Hypha-Home/HyphaHome-Sens/case/Hypha Home - Sense.3mf

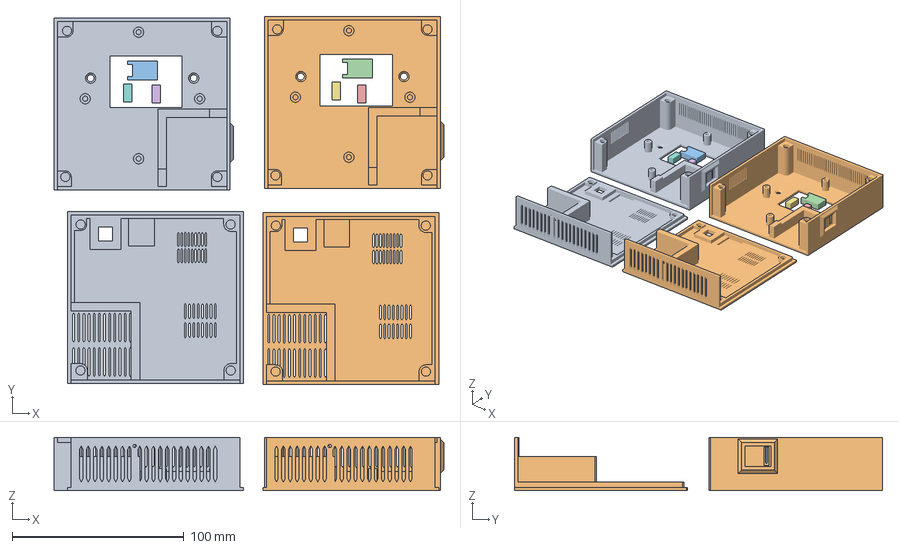
[picture p7: CAD file, 2026-10-26]
case/Hypha Home - Sense.3mf
226.9 x 214.2 x 31.0 mm
Backplate x 2
Abstandshalter LD2410 x 2
Abstandshalter x 4
Front x 2
