Hypha-Home/HyphaHome-Sens/case/Front.3mf

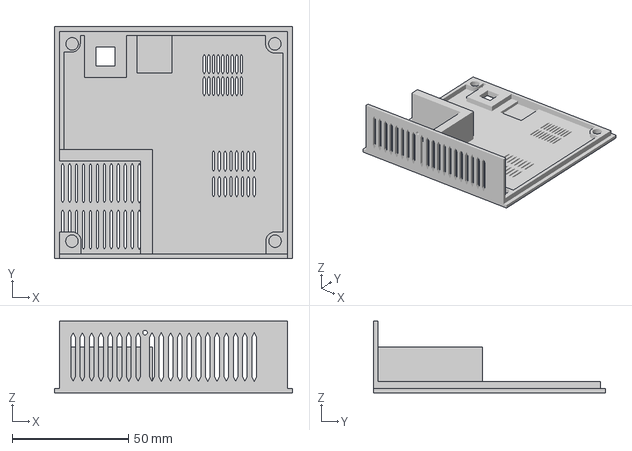
[picture p8: CAD file, 2026-10-26]
case/Front.3mf
102.5 x 100.0 x 31.0 mm
