Hypha-Home/HyphaHome-Sens/(list of files, cad)

Other CAD files:
case/Multisensor V2.f3d
