Hypha-Home/HyphaHome-Sens/hardware/Hypha Home - Sens - Rev.2/Hypha Home - Sens - Rev.2.kicad_pcb

## KiCad design hardware/Hypha Home - Sens - Rev.2/Hypha Home - Sens - Rev.2.kicad_pcb (2026-10-26)

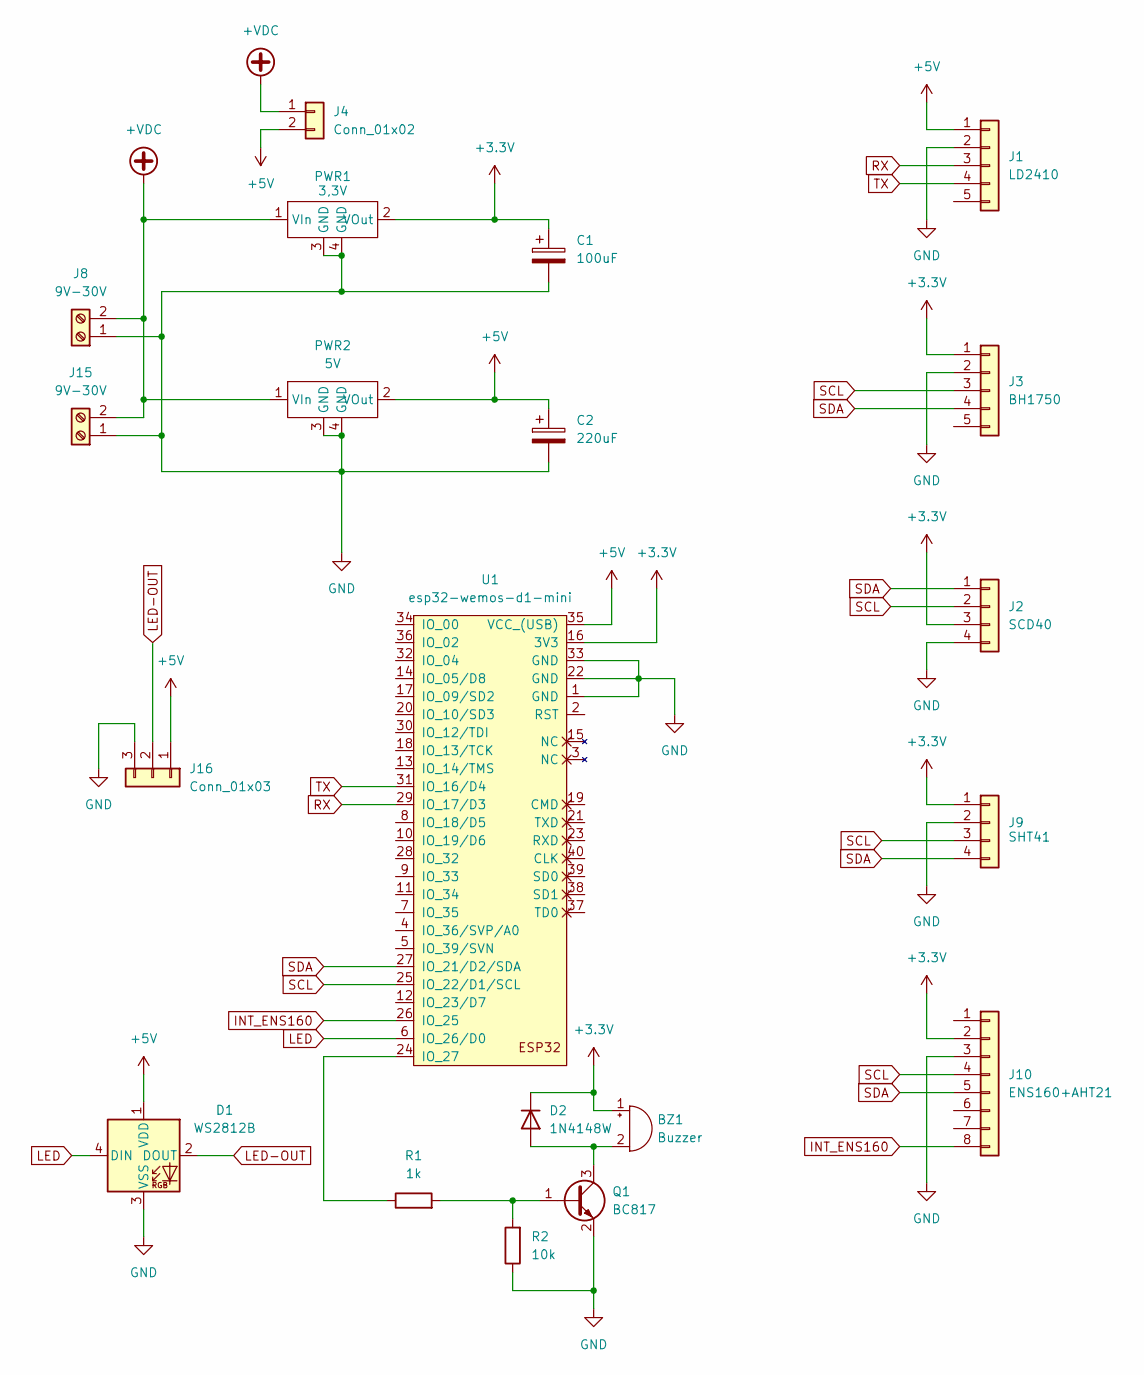
[picture p9: schematic Hypha Home - Sens - Rev.2.kicad_sch]

Parts:
BZ1: Buzzer; Buzzer_D9_RM5
C1: 100uF; CP_Radial_D5.0mm_P2.00mm
C2: 220uF; CP_Radial_D6.3mm_P2.50mm
D1: WS2812B; LED_WS2812B_PLCC4_5.0x5.0mm_P3.2mm
D2: 1N4148W; D_SOD-323_HandSoldering
J1: LD2410; PinHeader_1x05_P1.27mm_Vertical
J2: SCD40; PinHeader_1x04_P2.54mm_Vertical
J3: BH1750; PinHeader_1x05_P2.54mm_Vertical
J4: Conn_01x02; PinHeader_1x02_P2.54mm_Vertical
J8, J15: 9V-30V; TerminalBlock_MaiXu_MX126-5.0-02P_1x02_P5.00mm
J9: SHT41; PinHeader_1x04_P2.54mm_Vertical
J10: ENS160+AHT21; PinHeader_1x08_P2.54mm_Vertical
J16: Conn_01x03; PinHeader_1x03_P2.54mm_Vertical
PWR1: 3,3V; Spannungswandler
PWR2: 5V; Spannungswandler
Q1: BC817; SOT-23
R1: 1k; R_0805_2012Metric
R2: 10k; R_0805_2012Metric
U1: esp32-wemos-d1-mini

Connections:
+3.3V: BZ1.1 (+), C1.1, D2.1 (K), J2.3, J3.1, J9.1, J10.2, PWR1.2 (VOut), U1.16 (3V3)
+5V: C2.1, D1.1 (VDD), J1.1, J4.2, J16.1, PWR2.2 (VOut), U1.35 (VCC_(USB))
+VDC: J4.1, J8.2, J15.2, PWR1.1 (VIn), PWR2.1 (VIn)
GND: C1.2, C2.2, D1.3 (VSS), J1.2, J2.4, J3.2, J8.1, J9.2, J10.3, J15.1, J16.3, PWR1.3 (GND), PWR1.4 (GND), PWR2.3 (GND), PWR2.4 (GND), Q1.2 (E), R2.1, U1.1 (GND), U1.22 (GND), U1.33 (GND)
INT_ENS160: J10.8, U1.26 (IO_25)
LED: D1.4 (DIN), U1.6 (IO_26/D0)
LED-OUT: D1.2 (DOUT), J16.2
unnamed: BZ1.2 (-), D2.2 (A), Q1.3 (C)
unnamed: Q1.1 (B), R1.2, R2.2
unnamed: R1.1, U1.24 (IO_27)
RX: J1.3, U1.29 (IO_17/D3)
SCL: J2.2, J3.3, J9.3, J10.4, U1.25 (IO_22/D1/SCL)
SDA: J2.1, J3.4, J9.4, J10.5, U1.27 (IO_21/D2/SDA)
TX: J1.4, U1.31 (IO_16/D4)

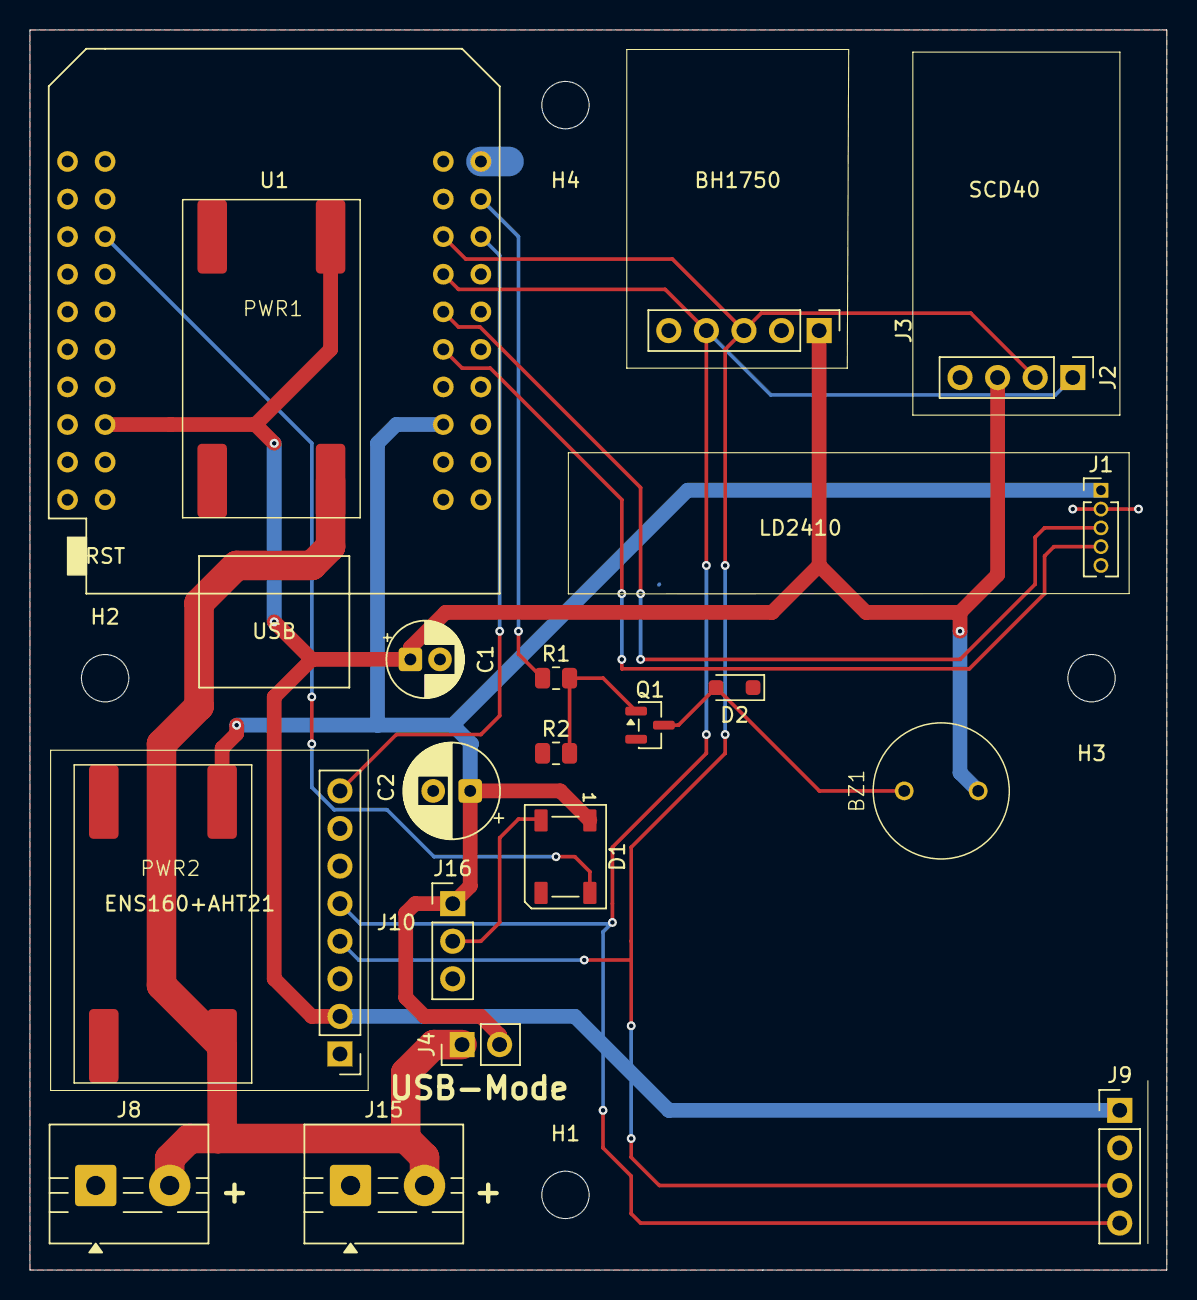
[picture p10: board Hypha Home - Sens - Rev.2.kicad_pcb from above]

Board: 2 copper layers, 76.8 x 83.8 mm, 24 parts (0 on the bottom side), 14 nets.

Other parts of the board:
H1, H2, H3, H4: MountingHole_3.2mm_M3
