Hypha-Home/HyphaHome-Sens/hardware/Hypha Home - Sens - Rev.1/Hypha Home - Sens - Rev.1.kicad_pcb

## KiCad design hardware/Hypha Home - Sens - Rev.1/Hypha Home - Sens - Rev.1.kicad_pcb (2026-10-26, an earlier design)

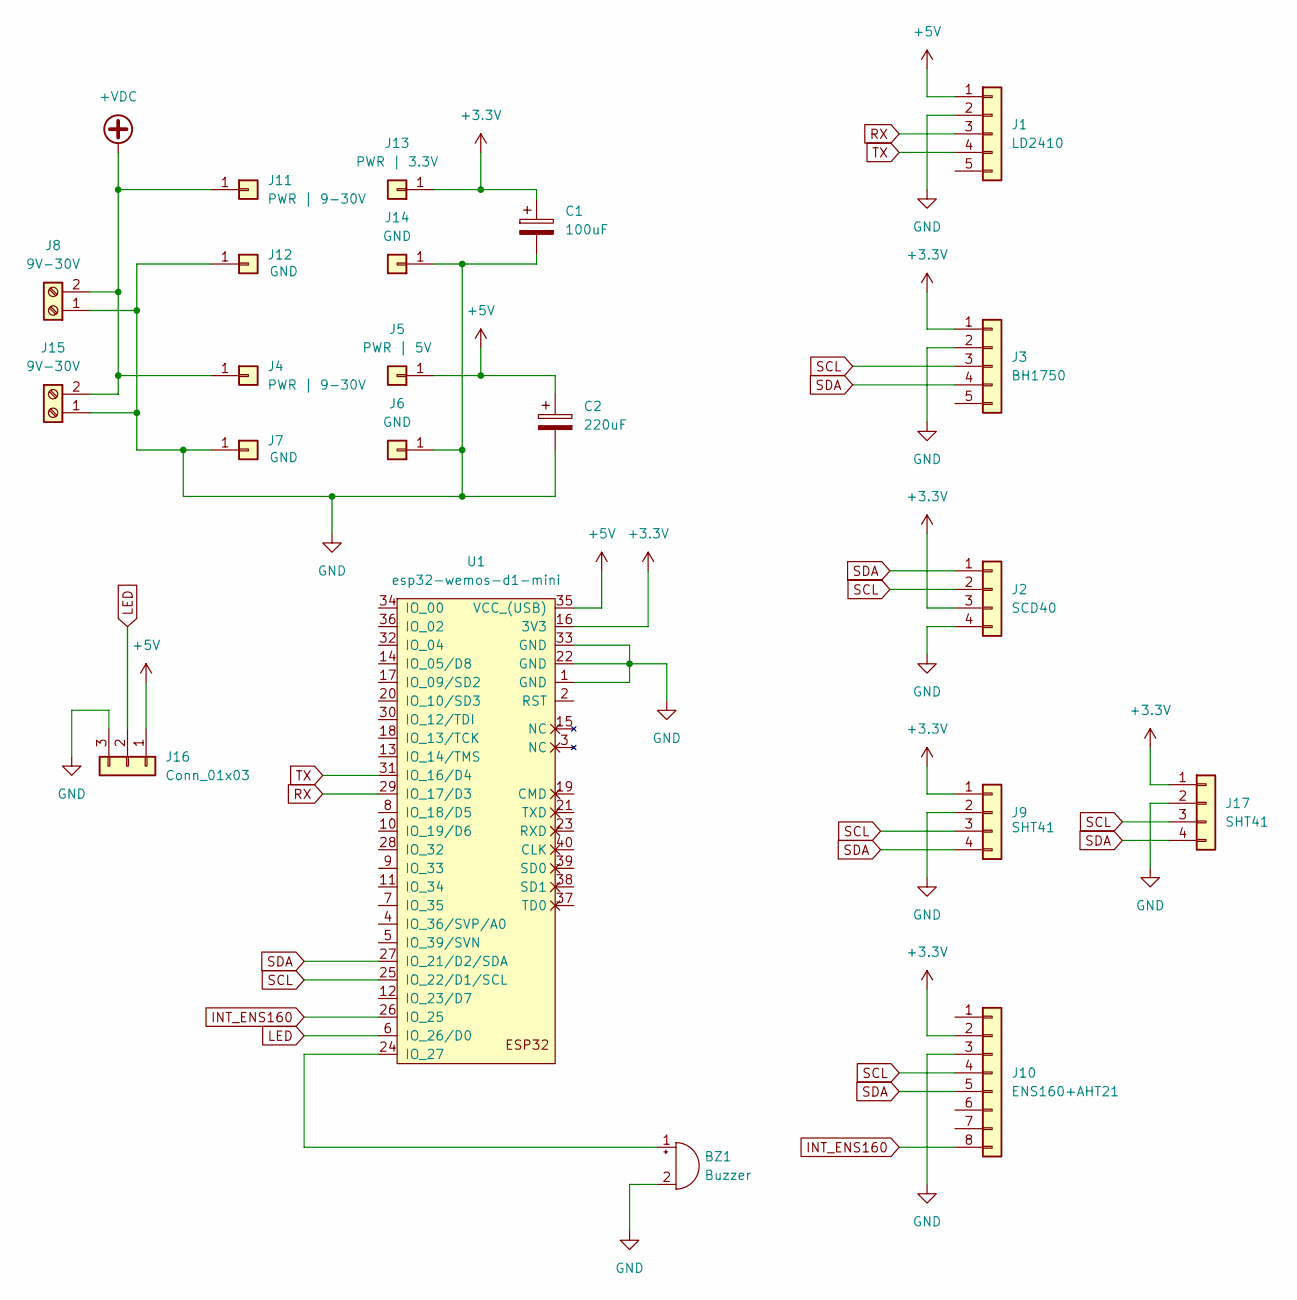
[picture p11: schematic Hypha Home - Sens - Rev.1.kicad_sch]

Parts:
BZ1: Buzzer; Buzzer_D9_RM5
C1: 100uF; CP_Radial_D5.0mm_P2.00mm
C2: 220uF; CP_Radial_D6.3mm_P2.50mm
J1: LD2410; PinHeader_1x05_P1.27mm_Vertical
J2: SCD40; PinHeader_1x04_P2.54mm_Vertical
J3: BH1750; PinHeader_1x05_P2.54mm_Vertical
J4, J11: PWR | 9-30V; PinHeader_1x01_P2.54mm_Vertical
J5: PWR | 5V; PinHeader_1x01_P2.54mm_Vertical
J6, J7, J12, J14: GND; PinHeader_1x01_P2.54mm_Vertical
J8, J15: 9V-30V; TerminalBlock_MaiXu_MX126-5.0-02P_1x02_P5.00mm
J9, J17: SHT41; PinHeader_1x04_P2.54mm_Vertical
J10: ENS160+AHT21; PinHeader_1x08_P2.54mm_Vertical
J13: PWR | 3.3V; PinHeader_1x01_P2.54mm_Vertical
J16: Conn_01x03; PinHeader_1x03_P2.54mm_Vertical
U1: esp32-wemos-d1-mini

Connections:
+3.3V: C1.1, J2.3, J3.1, J9.1, J10.2, J13.1 (Pin_1_1), J17.1, U1.16 (3V3)
+5V: C2.1, J1.1, J5.1 (Pin_1_1), J16.1, U1.35 (VCC_(USB))
+VDC: J4.1 (Pin_1_1), J8.2, J11.1 (Pin_1_1), J15.2
GND: BZ1.2 (-), C1.2, C2.2, J1.2, J2.4, J3.2, J6.1 (Pin_1_1), J7.1 (Pin_1_1), J8.1, J9.2, J10.3, J12.1 (Pin_1_1), J14.1 (Pin_1_1), J15.1, J16.3, J17.2, U1.1 (GND), U1.22 (GND), U1.33 (GND)
INT_ENS160: J10.8, U1.26 (IO_25)
LED: J16.2, U1.6 (IO_26/D0)
unnamed: BZ1.1 (+), U1.24 (IO_27)
RX: J1.3, U1.29 (IO_17/D3)
SCL: J2.2, J3.3, J9.3, J10.4, J17.3, U1.25 (IO_22/D1/SCL)
SDA: J2.1, J3.4, J9.4, J10.5, J17.4, U1.27 (IO_21/D2/SDA)
TX: J1.4, U1.31 (IO_16/D4)

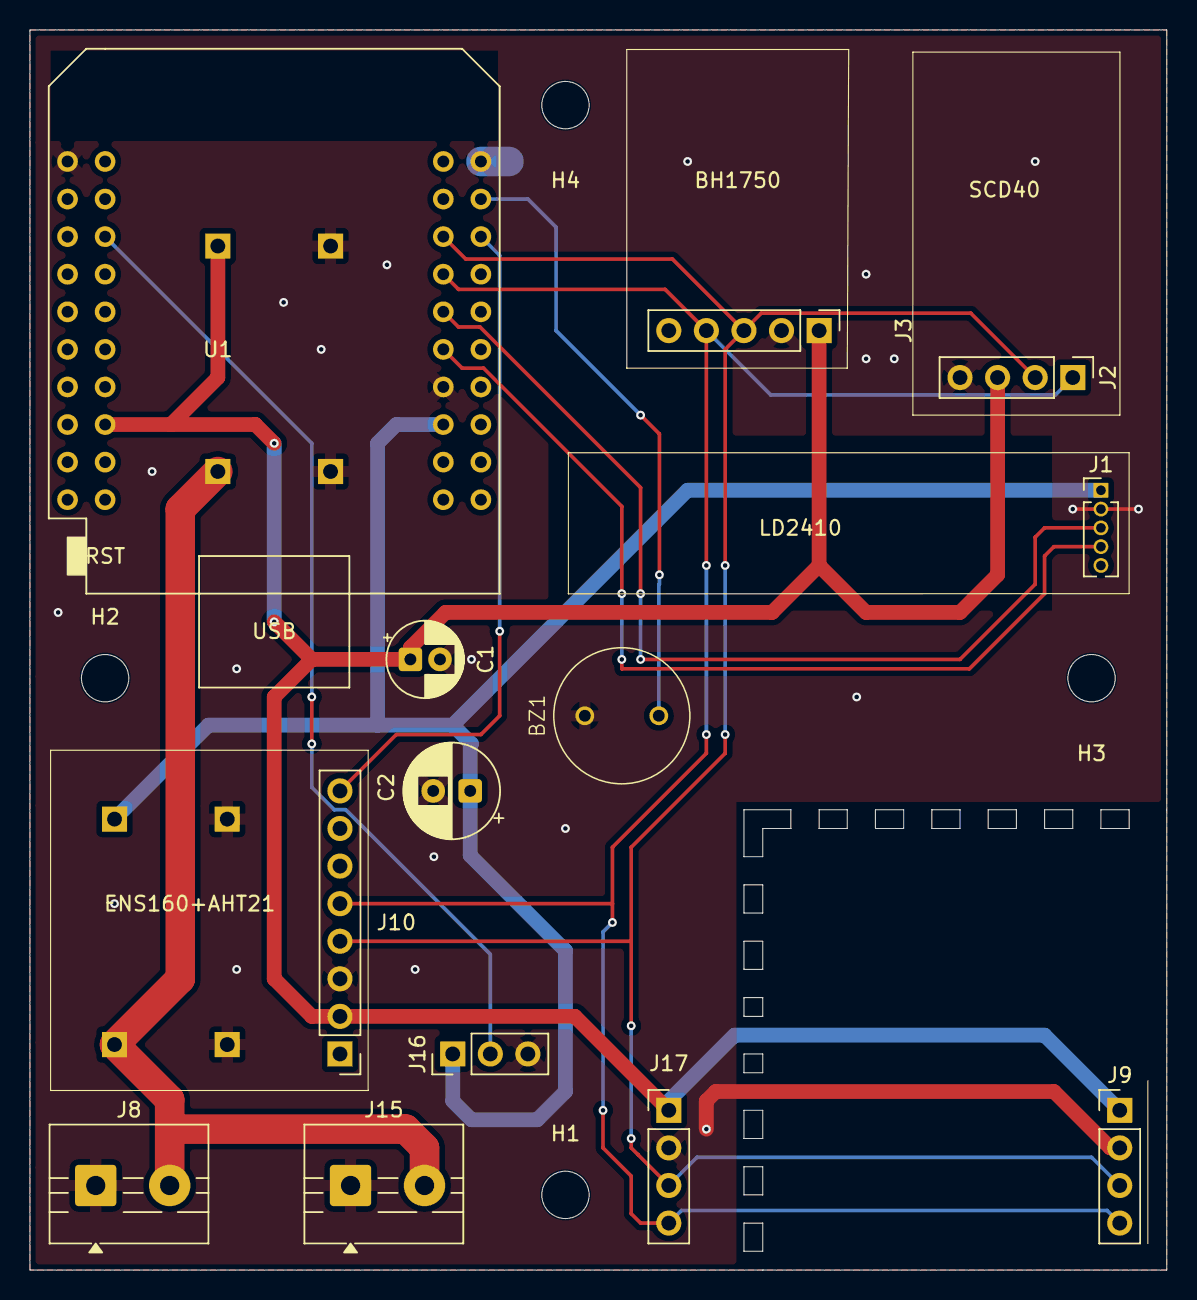
[picture p12: board Hypha Home - Sens - Rev.1.kicad_pcb from above]

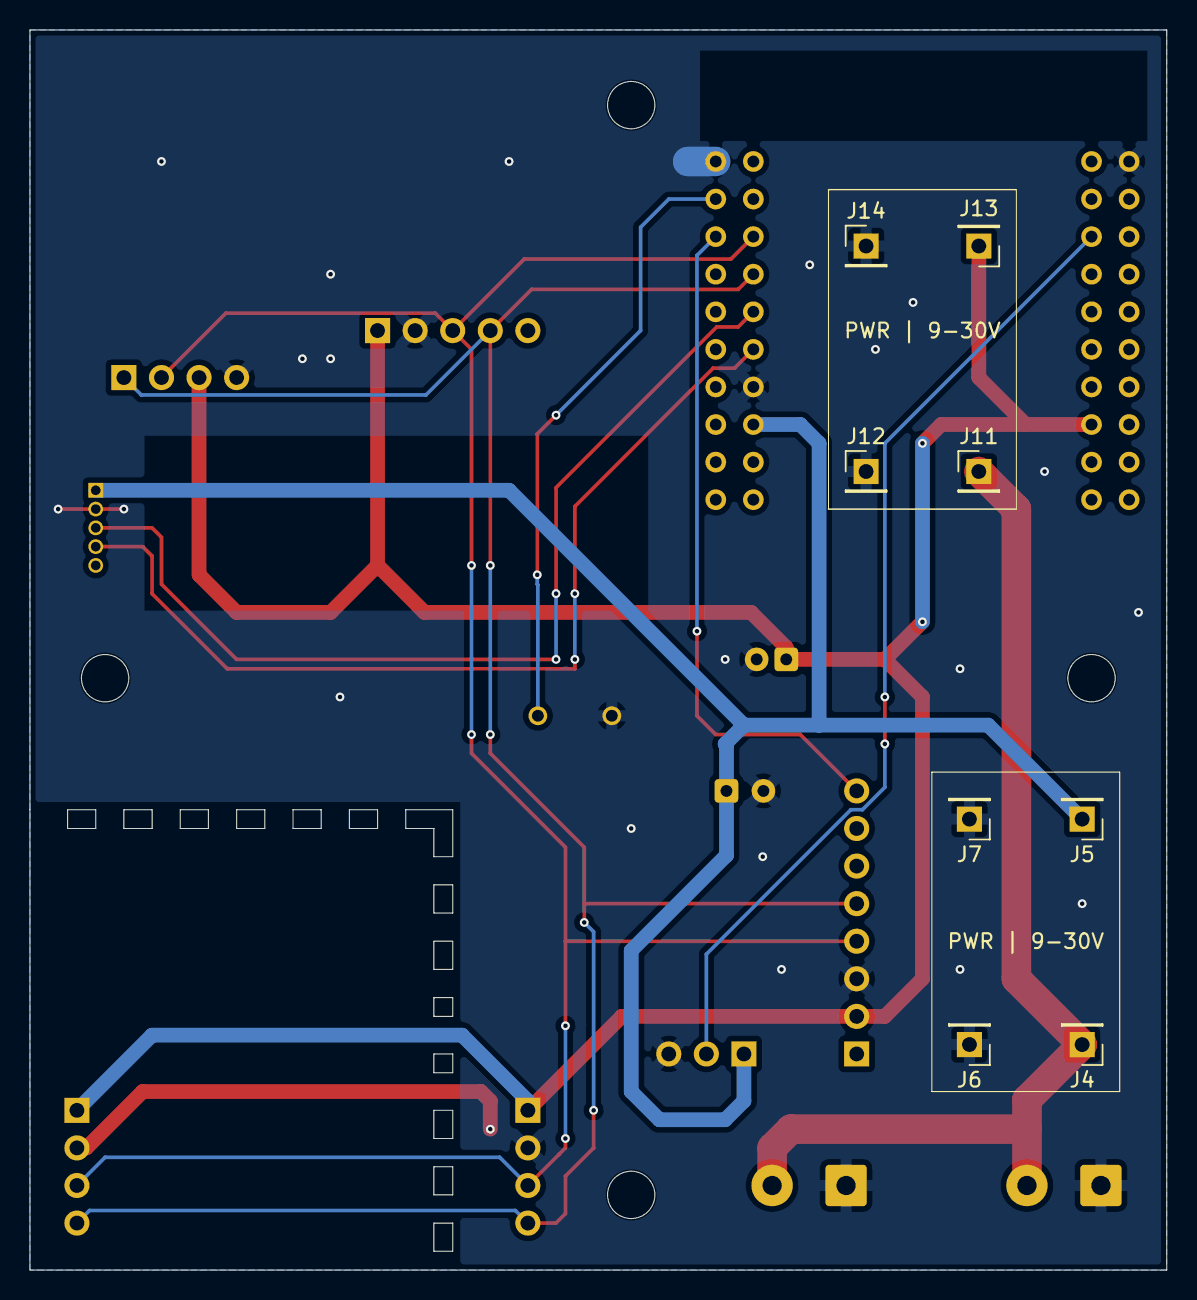
[picture p13: board Hypha Home - Sens - Rev.1.kicad_pcb from below]

Board: 2 copper layers, 76.8 x 83.8 mm, 25 parts (8 on the bottom side), 11 nets.

Other parts of the board:
H1, H2, H3, H4: MountingHole_3.2mm_M3
