Hypha-Home/HyphaHome-Sens/firmware/src/pinmapping.h

// ===================================================================
// File:            pinmapping.h
// Author:          EideardVMR
// Year:            2026
// Last modified:   2026-10-24
// ===================================================================
#pragma once

// I2C-Pin-Belegung
#define PIN_SDA 21
#define PIN_SCL 22

// LD2410-Pin-Belegung (UART)
#define PIN_LD2410_RX 16
#define PIN_LD2410_TX 17

// LED-Pin-Belegung
#define PIN_LED 26

// Beep-Pin-Belegung
#define PIN_BEEP 27
